davidemelozzi/Design-of-Ship-Structures/Sheetwork_DEN_DavideMelozzi.xlsx

Sheet: Ship Characteristics
Main Charateristics |  |  |  | Restriction of parameters
Lbp | 231 | [m] |  | Parameter | Min | Max | Unit | Description
B | 34.6 | [m] |  | B1 | 0.000 | 3.244 | [m] | Lenght of Bottom Tank
D | 18.1 | [m] |  | B2 | 4.325 | 6.055 | [m] | Lenght of bilge tank
T | 13.2 | [m] |  | S | 600 | 918 | [mm] | Space Framing
v | 18.2 | [kn] |  | h2 | 1.2 | 1.8 | [m] | Longitudinal Hatch
Cb | 0.78 | [-] |  | B3 | 17.3 | - | [m] | Cargo Hatch
 |  |  |  | l | 2754.000 | 4590 | [mm] | Stiffner Span
DNV Rules |  |  |  | Data for calculations
 | Rule | Real |  | LCB | 0.027 | [m]
Lbp | < 350 | 231.000 | [m] | ΔL | 11.55 | [m]
L/B | > 5 | 6.676 | [-] | R_b | 2.82 | [m]
B/D | < 2.5 | 1.912 | [-] | g | 9.810 | [m^2/s]
Cb | > 0.6 | 0.780 | [-] | ρ_sw | 1.025 | [t/m^3]
 |  |  |  | ρ_cargo | 0.800 | [t/m^3]

Sheet: Midship Section
Geometrical Basic Dimensions
B1 | 12000 | [mm]
B2 | 5300 | [mm]
B3 | 8650 | [mm]
B4 | 8651 | [mm]
C1 | 4480 | [mm]
C2 | 5006 | [mm]
C3 | 5794 | [mm]
h | 2000 | [mm]
h1 | 800 | [mm]
h2 | 1500 | [mm]
R_b | 2820 | [mm]
l | 3672 | [mm]
Plate Restrictions
 | Min Lenght [mm] | Max Lenght [mm]
Keel | 1955 | -
Bottom | 1955 | -
Inner Bottom | 1955 | -
Bilge | 1955 | -
Side | 1955 | 1800
Deck | 1955 | 1800

Sheet: Material Proprieties
Material Selection- Hull structural steel |  |  |  | Thickness Requirements | S2-B204 | Corrosion addition tk on number of components
 | Yield Stress [N/mm2] | Grade | f1 |  |  | Plates |  | Stiffeners
NV-NS | 235 | A,B,D, E | 1 |  |  | Number | tk [mm] | Number | tk [mm]
NV-27 | 265 | - | 1.08 |  |  | 1 | 1 | 1 | 1.5
NV-32 | 315 | - | 1.28 |  |  | 2 | 1 | 2 | 1.5
NV-36 | 355 | - | 1.39 |  |  | 3 | 1 | 3 | 1.5
NV-40 | 390 | - | 1.47 |  |  | 4 | 1 | 4 | 1.5
Ref | S2-B201 | S2-B202 | S2-B203 |  |  | 5 | 1 | 5 | 1.5
 |  |  |  |  |  | 6 | 1 | 6 | 1.5
Young Modulos for Steel |  |  |  |  |  | 7 | 1 | 7 | 1.5
E | 206000 | N/mm^2 |  |  |  | 8 | 1 | 8 | 1.5
 |  |  |  |  |  | 9 | 1 | 9 | 1.5
 |  |  |  |  |  | 10 | 1 | 10 | 1.5
SOLAS Requirements |  | S2-B302 |  |  |  | 11 | 0.5 | 11 | 1.5
 |  |  |  |  |  | 12 | 0.5 | 12 | 1.5
 |  |  |  |  |  | 13 | 0.5 | 13 | 1.5
 |  |  |  |  |  | 14 | 1 | 14 | 1.5
 |  |  |  |  |  | 15 | 1 | 15 | 1.5
 |  |  |  |  |  | 16 | 2 | 16 | 1.5
 |  |  |  |  |  | 17 | 2 | 17 | 1.5
 |  |  |  |  |  | 18 | 2 | 18 | 1.5
 |  |  |  |  |  | 19 | 2 | 19 | 1.5
 |  |  |  |  |  | 20 | 2 | 20 | 1.5
 |  |  |  |  |  | 21 | 2 | 21 | 1.5
 |  |  |  |  |  | 22 | 2 | 22 | 1.5
 |  |  |  |  |  | 23 | 2 | 23 | 1.5
 |  |  |  |  |  | 24 | 2 | 24 | 1.5
 |  |  |  |  |  | 25 | 1.5 | 25 | 1.5
 |  |  |  |  |  | 26 | 1.5 | 26 | 3
 |  |  |  |  |  | 27 | 1.5 | 27 | 3
 |  |  |  |  |  | 28 | 1.5 | 28 | 3
 |  |  |  |  |  | 29 | 1.5 | 29 | 3
 |  |  |  |  |  | 30 | 1.5 | 30 | 3
 |  |  |  |  |  | 31 | 1.5 | 31 | 3
 |  |  |  |  |  | 32 | 1.5 | 32 | 3
 |  |  |  |  |  | 33 | 1.5 | 33 | 3
 |  |  |  |  |  | 34 | 1.5 | 34 | 3
 |  |  |  |  |  | 35 | 1.5 | 35 | 3
 |  |  |  |  |  | 36 | 1.5 | 36 | 3
 |  |  |  |  |  | 37 | 1.5 | 37 | 3
 |  |  |  |  |  | 38 | 1.5 | 38 | 3
 |  |  |  |  |  | 39 | 1.5 | 39 | 1.5
 |  |  |  |  |  |  |  | 40 | 1.5
 |  |  |  |  |  |  |  | 41 | 1.5
 |  |  |  |  |  |  |  | 42 | 1.5
 |  |  |  |  |  |  |  | 43 | 1.5
 |  |  |  |  |  |  |  | 44 | 1.5
 |  |  |  |  |  |  |  | 45 | 1.5
 |  |  |  |  |  |  |  | 46 | 1.5
 |  |  |  |  |  |  |  | 47 | 1.5
 |  |  |  |  |  |  |  | 48 | 1
 |  |  |  |  |  |  |  | 49 | 1
 |  |  |  |  |  |  |  | 50 | 1.5
 |  |  |  |  |  |  |  | 51 | 1.5
 |  |  |  |  |  |  |  | 52 | 1.5
 |  |  |  |  |  |  |  | 53 | 1.5
 |  |  |  |  |  |  |  | 54 | 1.5
 |  |  |  |  |  |  |  | 55 | 1.5
 |  |  |  |  |  |  |  | 56 | 1.5
 |  |  |  |  |  |  |  | 57 | 1.5
 |  |  |  |  |  |  |  | 58 | 1.5
 |  |  |  |  |  |  |  | 59 | 1.5
 |  |  |  |  |  |  |  | 60 | 1.5
 |  |  |  |  |  |  |  | 61 | 1.5
 |  |  |  |  |  |  |  | 62 | 1.5
 |  |  |  |  |  |  |  | 63 | 1.5
 |  |  |  |  |  |  |  | 64 | 1.5
 |  |  |  |  |  |  |  | 65 | 1.5
 |  |  |  |  |  |  |  | 66 | 1.5
 |  |  |  |  |  |  |  | 67 | 1.5
 |  |  |  |  |  |  |  | 68 | 1.5
 |  |  |  |  |  |  |  | 69 | 1.5
 |  |  |  |  |  |  |  | 70 | 1.5
 |  |  |  |  |  |  |  | 71 | 1.5
 |  |  |  |  |  |  |  | 72 | 1.5
 |  |  |  |  |  |  |  | 73 | 1.5
 |  |  |  |  |  |  |  | 74 | 1.5
 |  |  |  |  |  |  |  | 75 | 1.5
 |  |  |  |  |  |  |  | 76 | 1.5
 |  |  |  |  |  |  |  | 77 | 1.5
 |  |  |  |  |  |  |  | 78 | 1.5
 |  |  |  |  |  |  |  | 79 | 1.5

Sheet: Design Load and Acceleration
Parameters for calculation |  |  |  | Roll motion and acceleration
Cw | 10.18 | [-] | S4-B201 | T_roll | 8.490 | [s] | S4 - B 402
Cv | 0.2 | [-] | S4-B203 | φ | 0.473 | [rad]
Cv1 | 1.20 | [-] | S4-B203 | a_roll | 1.711 | [m/s^2] | S4 - B 403
a0 | 0.37 | [-] | S4-B203 | R_roll | 6.6 | [m]
 |  |  |  | GM | 4.152 | [m] | S4 - B 402
 |  |  |  | kr | 8.65 | [m]
Surge,Sway/Yaw and Heave accelerations |  |  |  | k | 1 | [-] | S4 - B 401
Surge Acceleration |  |  |  | c | 1.038 | [-]
a_x | 0.644 | [m/s^2] | S4-B301
Combined Sway/Yaw Acceleration |  |  |  | Pitch motion and acceleration
a_y | 1.094 | [m/s^2] | S4-B302 | T_pitch | 8.735 | [s] | S4 - B 502
 |  |  |  | θ | 0.119 | [rad] | S4 - B 501
Heave Acceleration |  |  |  | a_pitch | 0.407 | [m/s^2] | S4 - B 503
a_z | 2.890 | [m/s^2] | S4-B303 | R_pitch | 6.6 | [m]
Combined Acceleration
Combined Vertical Acceleration
a(vert) | 3.272 | [m/s^2] | S4 - B 601
k(vert) | 0.7 | [-]
Combined Transverse Acceleration
a(trans) | 6.280 | [m/s^2] | S4 - B 701
Combined Longitudinal Acceleration
a(long) | 1.699 | [m/s^2] | S4 - B 801

Sheet: Longitudinal design strenght
Still water condition |  |  |  |  |  |  |  | Wave load condition |  |  |  |  |  |  |  |  | Horizontal bending moment on a wave load
S5-B106 to B108 |  |  |  |  |  |  |  | S5-B201 to B203 |  |  |  |  |  |  |  |  | S5-B205
Section | x [m] | ksm | MS (sagging) [kN.m] | MS (hogging) [kN.m] | ksq | QS (sagging) [kN] | QS (hogging) [kN] | Section | x [m] | ksm | MS (sagging) [kN.m] | MS (hogging) [kN.m] | ksq,neg | ksq,pos | QS (sagging) [kN] | QS (hogging) [kN] | Section | x [m] | x/L | M_wh [kN*m]
0 | 0 | 0 | 0 | 0 | 0.00 | 0 | 0 | 0 | 0 | 0.000 | 0 | 0 | 0.000 | 0.000 | 0 | 0 | 0 | 0 | 0 | 0
1 | 11.55 | 0.075 | -135565.5894 | 156139.9928 | 0.33 | -13041.42274 | 15020.68233 | 1 | 11.55 | 0.125 | -382364.483 | 348073.8107 | 0.230 | 0.209 | -8306.383101 | 7565.787546 | 1 | 11.55 | 0.05 | 41198.64356
2 | 23.1 | 0.15 | -271131.1788 | 312279.9856 | 0.67 | -26082.84549 | 30041.36466 | 2 | 23.1 | 0.250 | -764728.9659 | 696147.6213 | 0.460 | 0.419 | -16612.7662 | 15131.57509 | 2 | 23.1 | 0.1 | 160761.764
3 | 34.65 | 0.3625 | -655233.6822 | 754676.6319 | 1.00 | -39124.26823 | 45062.04698 | 3 | 34.65 | 0.375 | -1147093.449 | 1044221.432 | 0.690 | 0.628 | -24919.1493 | 22697.36264 | 3 | 34.65 | 0.15 | 346985.6899
4 | 46.2 | 0.575 | -1039336.186 | 1197073.278 | 1.00 | -39124.26823 | 45062.04698 | 4 | 46.2 | 0.500 | -1529457.932 | 1392295.243 | 0.920 | 0.838 | -33225.5324 | 30263.15018 | 4 | 46.2 | 0.2 | 581641.5261
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
 |  |  | Cw | Ms Sag [kN*m] | Ms Hog [kN*m] | Q Sag [kN*m] | Q Hog [kN*m] |  |  |  | Cw | Ms Sag [kN*m] | Ms Hog [kN*m] | Q Neg [kN*m] | Q Pos [kN*m]
 |  |  | 10.18 | -1807541.192 | 2081866.571 | -39124.26823 | 45062.04698 |  |  |  | 10.18 | -3058915.864 | 2784590.485 | -36114.70914 | 36114.70914

Sheet: Bottom structures
 |  |  |  | Plates
 |  |  |  | Keel Plate
 |  |  |  | Plate | Breadth [m] | Breadth [m] | Material | Thickness [mm] | ICM [mm] | Gross Thickness [mm]
 |  |  |  | nº | b_min | b | f1 | t_min | tk | t
 |  |  |  | 1 | 1.955 | 2 | 1.39 | 17.80 | 1 | 18
 |  |  |  |  | S6 - C 201 |  |  | S6 - C 202
 |  |  |  | Bottom and bilge plates
 |  |  |  | Plate | Breadth [m] | Thickness [mm] | Breadth [m] | Thickness [mm] |  | s | p1 | p2 | p3 | p | σ | pdp | pl | y | z | kf | hs | Material
 |  |  |  | nº | b | t | b_min | t_min | t_req | [m] | [kN/m^2] | [kN/m^2] | [kN/m^2] | [kN/m^2] | [-] | [kN/m^2] | [-] | [m] | [m] | [m] | [m] | f1
 |  |  |  | 2 | 2.25 | 15 | 1.955 | 14.3 | 13.8 | 0.75 | 152.1 | -22.7 | -11.1 | 152.1 | 139.0 | 20.1 | 25.3 | 8.65 | 0 | 4.9 | 2 | 1.39
 |  |  |  | 3 | 2.25 | 15 | 1.955 | 14.3 | 13.8 | 0.75 | 152.1 | -22.7 | -11.1 | 152.1 | 139.0 | 20.1 | 25.3 | 8.65 | 0 | 4.9 | 2 | 1.39
 |  |  |  | 4 | 2.25 | 15 | 1.955 | 14.3 | 13.8 | 0.75 | 152.1 | -22.7 | -11.1 | 152.1 | 139.0 | 20.1 | 25.3 | 8.65 | 0 | 4.9 | 2 | 1.39
 |  |  |  | 5 | 2.25 | 15 | 1.955 | 14.4 | 13.8 | 0.75 | 152.3 | -22.7 | -11.1 | 152.3 | 139.0 | 20.3 | 25.3 | 8.875 | 0 | 4.9 | 2 | 1.39
 |  |  |  | 6 | 2.25 | 15 | 1.955 | 14.5 | 13.8 | 0.75 | 155.1 | -22.7 | -11.1 | 155.1 | 139.0 | 23.1 | 25.3 | 11.125 | 0 | 4.9 | 2 | 1.39
 |  |  |  | 7 | 2.00 | 17 | 1.955 | 16.0 | 13.8 | 0.83 | 157.7 | -22.7 | -11.1 | 157.7 | 139.0 | 25.7 | 25.3 | 13.25 | 0 | 4.9 | 2 | 1.39
 |  |  |  | 8 | 4.89 | 17 | 1.955 | 16.3 | 13.8 | 0.83 | 162.7 | 0.7 | 9.0 | 162.7 | 139.0 | 30.7 | 25.3 | 16.475 | 0.826 | 4.9 | 4 | 1.39
 |  |  |  | 9 | 2.33 | 17 | 1.955 | 16.7 | 13.6 | 0.88 | 167.8 | -8.7 | 1.0 | 167.8 | 153.0 | 35.8 | 25.3 | 17.3 | 4.2125 | 4.9 | 3.2 | 1.47
 |  |  |  | 10 | 2.33 | 17 | 1.955 | 16.8 | 13.6 | 0.88 | 170.6 | -34.5 | -21.1 | 170.6 | 153.0 | 38.6 | 25.3 | 17.3 | 6.5375 | 4.9 | 1 | 1.47
 |  |  |  |  |  |  | S6 - C 301 | S6 - C 304 | S6 - C 302 |  | S6 - Table B1 |  |  |  | S6 - C 302 | S4 - C 201 | S4 - C 302
 |  |  |  | Inner bottom plating
 |  |  |  | Plate | Breadth [m] | Thickness [mm] | Breadth [m] | Thickness [mm] |  | s | p4 | p13 | p14 | p15 | p | σ | pdp | pl | y | z | kf | hc | hp | Δpdyn | hs | Material
Constant values |  |  |  | nº | b | t | b_min | t_min | t_req | [m] | [kN/m^2] | [kN/m^2] | [kN/m^2] | [kN/m^2] | [kN/m^2] | [-] | [kN/m^2] | [-] | [m] | [m] | [m] | [-] | [m] | [kN/m^2] | [m] | f1
p0 | 15 | kN/m~2 | S4 - C 302 | 28 | 3.73 | 15 | 1.955 | 14.11 | 13.22 | 0.83 | 158.38 | 108.54 | 88.00 | 132.00 | 158.38 | 198.47 | 36.32 | 25.25 | 16 | 6 | 4.9 | 13.5 | 13.7 | 25 | 7.3 | 1.47
t0 | 6 | mm | S6 C402 | 29 | 3.73 | 15 | 1.955 | 14.59 | 13.22 | 0.83 | 170.70 | 123.95 | 124.00 | 132.00 | 170.70 | 198.47 | 29.88 | 25.25 | 13.4 | 3.3 | 4.9 | 14.55 | 16 | 25 | 10.9 | 1.47
ka | 1.08 | [-] | S6 - A 201 | 30 | 3.025 | 14 | 1.955 | 13.94 | 13.22 | 0.75 | 188.89 | 134.67 | 158.90 | 132.00 | 188.89 | 198.47 | 24.75 | 25.25 | 10.5 | 2 | 4.9 | 16.1 | 17.6 | 25 | 14.39 | 1.47
f2b | 0.868 | [-] |  | 31 | 3.025 | 14 | 1.955 | 13.94 | 13.22 | 0.75 | 188.89 | 134.67 | 176.00 | 132.00 | 188.89 | 198.47 | 22.47 | 25.25 | 8.65 | 2 | 4.9 | 16.1 | 17.6 | 25 | 16.1 | 1.47
Zb | 31941165.65 | [cm^3] |  | 32 | 2.525 | 14 | 1.955 | 13.94 | 13.22 | 0.75 | 188.89 | 134.67 | 176.00 | 132.00 | 188.89 | 198.47 | 22.47 | 25.25 | 8.65 | 2 | 4.9 | 16.1 | 17.6 | 25 | 16.1 | 1.47
I | 1.927116994e+10 | [cm^4] | S5-C401 | 33 | 2.525 | 14 | 1.955 | 13.94 | 13.22 | 0.75 | 188.89 | 134.67 | 176.00 | 132.00 | 188.89 | 198.47 | 22.47 | 25.25 | 8.65 | 2 | 4.9 | 16.1 | 17.6 | 25 | 16.1 | 1.47
Tm | 4.62 | [m] | S6 - C 402 | 34 | 2 | 14 | 1.955 | 13.94 | 13.22 | 0.75 | 188.89 | 134.67 | 176.00 | 132.00 | 188.89 | 198.47 | 22.47 | 25.25 | 8.65 | 2 | 4.9 | 16.1 | 17.6 | 25 | 16.1 | 1.47
ks | 2 | [-] | S4-C201 |  |  |  |  | S6 - C 402 | S6 - C 401 |  | S6 - Table B1 |  |  |  |  | S6 - C 302 | S4 - C 201 |  |  |  |  |  |  | S4 - C 302
f | 4.9 | [m] | S4 - C 201
Z_NA | 6.03 | [m] | p | Longitudinal Girder
 |  |  |  | Plate | Breadth [m] | Thickness [mm] | Thickness [mm] |  | k | s | p13 | p14 | p15 | p | σ | hp | Δpdyn | hs | Material
 |  |  |  | nº | b | t | t_min | t_req | [-] | [m] | [kN/m^2] | [kN/m^2] | [kN/m^2] | [kN/m^2] | [-] | [m] | [kN/m^2] | [m] | f1
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
 |  |  |  | 73 | 972.2280707 | 10 | 66.73510531 | 9.5 | 66.73510531 | 3.672 | 3.465 | 0.8 | 1.09 | 174.2 | 144.05 | 144.05 | 29 | 132 | 1.4 | 19 | 25 | 1.28
 |  |  |  | 74 | 936.0521425 | 10 | 66.73510531 | 9.5 | 65.06922095 | 3.672 | 3.465 | 0.8 | 1.09 | 174.2 | 138.69 | 138.69 | 21 | 132 | 0.6 | 18.2 | 25 | 1.28
 |  |  |  | 75 | 972.2280707 | 10 | 66.73510531 | 9.5 | 66.73510531 | 3.672 | 3.465 | 0.8 | 1.09 | 174.2 | 144.05 | 144.05 | 29 | 132 | 1.4 | 19 | 25 | 1.28
 |  |  |  | 76 | 936.0521425 | 10 | 66.73510531 | 9.5 | 65.06922095 | 3.672 | 3.465 | 0.8 | 1.09 | 174.2 | 138.69 | 138.69 | 21 | 132 | 0.6 | 18.2 | 25 | 1.28
 |  |  |  | 77 | 972.2280707 | 10 | 66.73510531 | 9.5 | 66.73510531 | 3.672 | 3.465 | 0.8 | 1.09 | 174.2 | 144.05 | 144.05 | 29 | 132 | 1.4 | 19 | 25 | 1.28
 |  |  |  | 78 | 936.0521425 | 10 | 66.73510531 | 9.5 | 65.06922095 | 3.672 | 3.465 | 0.8 | 1.09 | 174.2 | 138.69 | 138.69 | 21 | 132 | 0.6 | 18.2 | 25 | 1.28
 |  |  |  | 79 | 972.2280707 | 10 | 66.73510531 | 9.5 | 66.73510531 | 3.672 | 3.465 | 0.8 | 1.09 | 174.2 | 144.05 | 144.05 | 29 | 132 | 1.4 | 19 | 25 | 1.28

Sheet: Side structures
 |  |  |  | Plates
 |  |  |  | Side Plates
 |  |  |  | Plate | Breadth [m] | Thickness [mm] | t_min | t_req | k | σ | s | p | p1 | p2 | p6 | p8 | pdp | pl | y | z | kf | h0 | hs | bb | Material
 |  |  |  | nº | b | t | [mm] | [mm] | [-] | [-] | [m] | [kN/m^2] | [kN/m^2] | [kN/m^2] | [kN/m^2] | [kN/m^2] | [KN/m^2] | [-] | [m] | [m] | [m] | [m] | [m] | [m] | f1
 |  |  |  | 11 | 1.8 | 14 | 7.54 | 13.30 | 0.01 | 153.6 | 0.918 | 103.2439296 | 77.64372393 | - | 103.2439296 | 73.46272 | 31.64372393 | 15.85441736 | 17.3 | 8.6 | 4.9 | 4.6 | 9.5 | 34.6 | 1.28
 |  |  |  | 12 | 1.8 | 13 | 7.54 | 12.70 | 0.01 | 153.6 | 0.918 | 93.77924161 | 61.80372393 | - | 93.77924161 | 73.46272 | 33.80372393 | 15.85441736 | 17.3 | 10.4 | 4.9 | 2.8 | 7.7 | 34.6 | 1.28
 |  |  |  | 13 | 1.8 | 13 | 7.54 | 12.07 | 0.01 | 153.6 | 0.918 | 84.31455361 | 45.96372393 | - | 84.31455361 | 73.46272 | 35.96372393 | 15.85441736 | 17.3 | 12.2 | 4.9 | 1 | 5.9 | 34.6 | 1.28
 |  |  |  | 14 | 1.8 | 11 | 8.04 | 10.02 | 0.01 | 179.2 | 0.725 | 95.90139031 | - | 34.28372393 | 95.90139031 | - | 37.16372393 | 15.85441736 | 17.3 | 13.2 | 4.9 | 0.8 | 4.1 | 34.6 | 1.28
 |  |  |  | 15 | 1.8 | 10 | 8.04 | 9.43 | 0.01 | 179.2 | 0.725 | 83.77475881 | - | 27.80372393 | 83.77475881 | - | 37.16372393 | 15.85441736 | 17.3 | 13.2 | 4.9 | 2.6 | 2.3 | 34.6 | 1.28
 |  |  |  |  |  |  | S7-C102 | S7-C101 | S7-C102 |  |  | S7-B100
 |  |  |  | Shear Strake
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
p0 | 15 | kN/m^2 | S4 - C 302
 | 25
ka | 1.08 | [-]
b | 25.95 | m | S7 - B 101
f2d | 1.74 | [-]
T ballast | 4.62 | [m] | S6 - C 402

Sheet: Deck structures
 |  |  |  | Plates
 |  |  |  | Strength deck plates
 |  |  |  | Plate | Breadth [m] | Thickness [mm] | t_min | t_req | t0 | k | s | σ | p | p1 | p7 | p8 | pdp | pl | y | z | kf | hp | Δpdyn | hs | h0 | Material
 |  |  |  | nº | b | t | [mm] | [mm] | [-] | [-] | [m] | [-] | [KN/m^2] | [KN/m^2] | [KN/m^2] | [KN/m^2] | [KN/m^2] | [-] | [m] | [m] | [m] | [m] | [kN/m^2] | [m] | [m] | f1
 |  |  |  | 17 | 1.8 | 12 | 11.42 | 8.82 | 5.5 | 0.02 | 0.865 | 166.8 | 26.9 | 19.1 | 26.9 | 15.0 | 45.45441583 | 25.25368591 | 16.4 | 13.2 | 4.9 | 1.5 | 25 | 0 | 4.9 | 1.39
 |  |  |  | 18 | 1.8 | 12 | 11.42 | 8.82 | 5.5 | 0.02 | 0.865 | 166.8 | 26.9 | 17.3 | 26.9 | 15.0 | 43.23726255 | 25.25368591 | 14.6 | 13.2 | 4.9 | 1.5 | 25 | 0 | 4.9 | 1.39
 |  |  |  | 19 | 1.8 | 12 | 11.42 | 8.82 | 5.5 | 0.02 | 0.865 | 166.8 | 26.9 | 15.6 | 26.9 | 15.0 | 41.02010926 | 25.25368591 | 12.8 | 13.2 | 4.9 | 1.5 | 25 | 0 | 4.9 | 1.39
 |  |  |  | 20 | 1.8 | 12 | 11.42 | 8.82 | 5.5 | 0.02 | 0.865 | 166.8 | 26.9 | 13.8 | 26.9 | 15.0 | 38.80295598 | 25.25368591 | 11 | 13.2 | 4.9 | 1.5 | 25 | 0 | 4.9 | 1.39
 |  |  |  | 21 | 1.8 | 12 | 11.42 | 8.82 | 5.5 | 0.02 | 0.865 | 166.8 | 26.9 | 12.0 | 26.9 | 15.0 | 36.5858027 | 25.25368591 | 9.2 | 13.2 | 4.9 | 1.5 | 25 | 0 | 4.9 | 1.39
 |  |  |  |  |  |  | S8 - C 104 | S8 - C 102 | S8 - C 104 |  |  | S8 - C 102 |  | S8 - table 1 |  |  |  | S4 - C 201 |  |  |  |  |  |  |  | S8 - B 101
 |  |  |  | Plates of deck below and above strength deck
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
 |  |  |  |  | 49 | 60.85093043 | 9 | 14 | 8.31 | 10.52011276 | 3 | 0.75 | 1.09 | 62.2 | 6.198671353 | 35.9 | 25.3 | 8.65 | 13.2 | 4.9 | 6.4 | 1.28

Sheet: Longitudinal components
Requirements |  |  |  |  |  |  | Requirements Maximum
Structure | Stiffener | SecMudul. [cm^3] | Thickness [mm] | Area [cm^2] | Material | Plate | Structure | SecMudul. [cm^3] | Thickness [mm] | Area [cm^2] | Longitudinal
 | nº | Z | t | A | f1 | nº |  | Z | t | A
Outer Bottom | 1 | 1067.7 | 10 | 85.23061778 | 1.28 | 1 | Outer Bottom | 1404 | 10 | 86 | HP400 X 16
 | 2 | 1067.7 | 10 | 85.23061778 | 1.28 | 2 | Inner Bottom | 1036 | 10 | 70 | HP370 X 15
 | 3 | 1067.7 | 10 | 85.23061778 | 1.28 |  | Double Bottom | 973 | 10 | 67 | HP340 x 12
 | 4 | 1067.7 | 10 | 85.23061778 | 1.28 | 3 | Side | 276 | 10 | 29 | HP220 X 10
 | 5 | 1067.7 | 10 | 85.23061778 | 1.28 |  | Shear Strake | 214 | 10 | 29 | HP220 X 10
 | 6 | 1067.7 | 10 | 85.23061778 | 1.28 |  | Strength Deck | 438 | 10 | 40 | HP260 x 12
 | 7 | 1067.7 | 10 | 85.23061778 | 1.28 | 4 | Below Deck | 1207 | 10 | 78 | HP370 X 13
 | 8 | 1067.7 | 10 | 85.23061778 | 1.28 |  | Above Deck | 87 | 9 | 14 | HP140 X 10
 | 9 | 1067.7 | 10 | 85.23061778 | 1.28 | 5 | Trans. Stiff. | 425.6138523 | - | 38.47566035 | HP260 x 12
 | 10 | 1077.2 | 10 | 85.23061778 | 1.28
 | 11 | 1083.7 | 10 | 85.23061778 | 1.28 | 6
 | 12 | 1090.2 | 10 | 85.23061778 | 1.28
 | 13 | 1221.5 | 10 | 85.23061778 | 1.28 | 7
 | 14 | 1229.5 | 10 | 85.23061778 | 1.28
 | 15 | 1237.4 | 10 | 85.23061778 | 1.28 | 8
 | 16 | 1368.4 | 10 | 85.23061778 | 1.28
 | 17 | 1377.1 | 10 | 85.23061778 | 1.28 | 9
 | 18 | 1385.8 | 10 | 85.23061778 | 1.28
 | 19 | 1394.5 | 10 | 85.23061778 | 1.28 | 10
 | 20 | 1403.2 | 10 | 85.23061778 | 1.28
Inner Bottom | 50 | 1025.7 | 10 | 69.58237648 | 1.28 | 28
 | 51 | 1025.7 | 10 | 69.58237648 | 1.28
 | 52 | 1025.7 | 10 | 69.58237648 | 1.28
 | 53 | 1025.7 | 10 | 69.58237648 | 1.28
 | 54 | 1025.7 | 10 | 69.58237648 | 1.28 | 29
 | 55 | 1025.7 | 10 | 69.58237648 | 1.28
 | 56 | 1025.7 | 10 | 69.58237648 | 1.28
 | 57 | 1027.1 | 10 | 69.58237648 | 1.28
 | 58 | 1035.1 | 10 | 69.58237648 | 1.28 | 30
 | 59 | 1035.1 | 10 | 69.58237648 | 1.28
 | 60 | 1035.1 | 10 | 69.58237648 | 1.28
 | 61 | 1035.1 | 10 | 69.58237648 | 1.28 | 31
 | 62 | 1035.1 | 10 | 69.58237648 | 1.28
 | 63 | 1035.1 | 10 | 69.58237648 | 1.28
 | 64 | 1035.1 | 10 | 69.58237648 | 1.28 | 32
 | 65 | 1035.1 | 10 | 69.58237648 | 1.28
 | 66 | 1035.1 | 10 | 69.58237648 | 1.28
 | 67 | 1035.1 | 10 | 69.58237648 | 1.28 | 33
 | 68 | 1035.1 | 10 | 69.58237648 | 1.28
 | 69 | 1035.1 | 10 | 69.58237648 | 1.28 | 34
Double Bottom | 70 | 936.1 | 10 | 66.73510531 | 1.28 | 35
 | 71 | 972.2 | 10 | 66.73510531 | 1.28
 | 72 | 936.1 | 10 | 66.73510531 | 1.28 | 36
 | 73 | 972.2 | 10 | 66.73510531 | 1.28
 | 74 | 936.1 | 10 | 66.73510531 | 1.28 | 37
 | 75 | 972.2 | 10 | 66.73510531 | 1.28
 | 76 | 936.1 | 10 | 66.73510531 | 1.28 | 38
 | 77 | 972.2 | 10 | 66.73510531 | 1.28
 | 78 | 936.1 | 10 | 66.73510531 | 1.28 | 39
 | 79 | 972.2 | 10 | 66.73510531 | 1.28
Side | 21 | 275.9 | 10 | 29 | 1.28 | 13
 | 22 | 262.8 | 10 | 29 | 1.28 | 14
 | 23 | 249.6 | 10 | 29 | 1.28
 | 24 | 236.4 | 10 | 29 | 1.28 | 15
 | 25 | 223.3 | 10 | 29 | 1.28
 | 26 | 227.5 | 10 | 29 | 1.28
Shear Strake | 27 | 213.2 | 10 | 29 | 1.28 | 16
Strenght Deck | 28 | 437.8 | 10 | 40 | 1.28 | 17
 | 29 | 437.8 | 10 | 40 | 1.28
 | 30 | 437.8 | 10 | 40 | 1.28 | 18
 | 31 | 437.8 | 10 | 40 | 1.28
 | 32 | 437.8 | 10 | 40 | 1.28 | 19
 | 33 | 437.8 | 10 | 40 | 1.28
 | 34 | 437.8 | 10 | 40 | 1.28 | 20
 | 35 | 437.8 | 10 | 40 | 1.28
 | 36 | 437.8 | 10 | 40 | 1.28 | 21
Below Deck | 37 | 47.6 | 10 | 78 | 1.28 | 23
 | 38 | 670.3 | 10 | 78 | 1.28 | 24
 | 39 | 672.9 | 9 | 78 | 1.28
 | 40 | 726.7 | 9 | 78 | 1.28 | 25
 | 41 | 780.4 | 9 | 78 | 1.28
 | 42 | 834.2 | 9 | 78 | 1.28
 | 43 | 887.9 | 9 | 78 | 1.28 | 26
 | 44 | 965.7 | 9 | 78 | 1.28
 | 45 | 1045.9 | 9 | 78 | 1.28
 | 46 | 1126.1 | 9 | 78 | 1.28 | 27
 | 47 | 1206.3 | 9 | 78 | 1.28
Above Deck | 48 | 86.8 | 9 | 14 | 1.28 | 22
 | 49 | 60.9 | 9 | 14 | 1.28

Sheet: Neutral Axis Correction
Plates
Structure | Plate | h | b | I0 | A | z | A.z | A.z^2 | I |  | Designation | A | h | tw | Plate area | Dist. of CG [mm] |  | 2nd mom. of area [cm^4] |  | Elastic modulus [cm^3]
 | nº | [m] | [mm] | [m^4] | [m^2] | [m] | [m^3] | [m^4] | [m^4] |  |  | [cm^2] | [mm] | [mm] | [cm^2] | x | y | Ix | Iy | xx | yy
Outer Bottom | 1 | 0.009 | 1 | 6.075e-08 | 0.009 | 0.018 | 0.000162 | 0.3264636887 | 0.3264637495 |  | HP140x10 | 16.630 | 140 | 10 | 60 | 79.2 | 7.00 | 316 | 5.56 | 39.80 | 7.94
 | 2 | 0.015 | 2.25 | 6.328125e-07 | 0.03375 | 0.015 | 0.00050625 | 1.225458747 | 1.22545938 |  | HP160x9 | 17.800 | 160 | 9 | 60 | 93.6 | 7.10 | 448 | 7.32 | 47.90 | 10.30
 | 3 | 0.015 | 2.25 | 6.328125e-07 | 0.03375 | 0.015 | 0.00050625 | 1.225458747 | 1.22545938 |  | HP180x10 | 22.46 | 180 | 10 | 60 | 106 | 8.10 | 717 | 12.05 | 67.80 | 14.90
 | 4 | 0.015 | 2.25 | 6.328125e-07 | 0.03375 | 0.015 | 0.00050625 | 1.225458747 | 1.22545938 |  | HP200x9 | 23.66 | 200 | 9 | 100 | 121 | 8.40 | 941 | 15.76 | 77.70 | 18.80
 | 5 | 0.015 | 2.25 | 6.328125e-07 | 0.03375 | 0.015 | 0.00050625 | 1.225458747 | 1.22545938 |  | HP200x10 | 25.660 | 200 | 10 | 100 | 119 | 8.70 | 1020 | 17.21 | 85.00 | 19.80
 | 6 | 0.015 | 2.25 | 6.328125e-07 | 0.03375 | 0.015 | 0.00050625 | 1.225458747 | 1.22545938 |  | HP200x12 | 29.660 | 200 | 12 | 100 | 117 | 9.40 | 1160 | 20.46 | 99.60 | 21.80
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
 | 47 | 370 | 13 | 1.767e-06 | 0.00697 | 12.75 | 0.0888675 | 0.313746076 | 0.313747843
Above Deck | 48 | 140 | 10 | 3.16e-06 | 0.001663 | 18.85 | 0.03134755 | 0.2728590627 | 0.2728622227 | HP140 X 10
 | 49 | 140 | 10 | 3.16e-06 | 0.001663 | 19.6 | 0.0325948 | 0.3057471276 | 0.3057502876

Sheet: Buckling
 |  | Thicknesses |  |  |  |  |  |  |  | Ideal elastic buckling stress |  | Yield stress of material | Critical buckling stress | Compressive stress in plate
 | Plate | t_initial | t_final | t_addiction | tk | η | k | ψ | s | σel | f1 | σf | σc | σa | Z _bottom | zn | za | ZND
 | nº | [mm] | [mm] | [mm] | [mm] | [-] | [-] | [-] | [m] | [N/mm^2] | [-] | [N/mm^2] | [N/mm^2] | [N/mm^2] | [m] | [m] | [m] | [m]
Outer Bottom | 1 | 18 | 15 | 0 | 1 | 0.9 | 4.00 | 1 | 0.75 | 258.4064 | 1.39 | 355 | 233.1 | 162.3 | 0.018 | 7.56 | 0.016 | 10.54 | OK
 | 2 | 15 | 15 | 0 | 1 | 0.9 | 4.00 | 1 | 0.75 | 258.4064 | 1.39 | 355 | 233.1 | 162.3 | 0.015 | 7.56 | 0.015 | 10.54 | OK
 | 3 | 15 | 15 | 0 | 1 | 0.9 | 4.00 | 1 | 0.75 | 258.4064 | 1.39 | 355 | 233.1 | 162.3 | 0.015 | 7.56 | 0.015 | 10.54 | OK
 | 4 | 15 | 15 | 0 | 1 | 0.9 | 4.00 | 1 | 0.75 | 258.4064 | 1.39 | 355 | 233.1 | 162.3 | 0.015 | 7.56 | 0.015 | 10.54 | OK
 | 5 | 15 | 15 | 0 | 1 | 0.9 | 4.00 | 1 | 0.75 | 258.4064 | 1.39 | 355 | 233.1 | 162.3 | 0.015 | 7.56 | 0.015 | 10.54 | OK
 | 6 | 15 | 15 | 0 | 1 | 0.9 | 4.00 | 1 | 0.75 | 258.4064 | 1.39 | 355 | 233.1 | 162.3 | 0.015 | 7.56 | 0.015 | 10.54 | OK
 | 7 | 17 | 16 | 0 | 1 | 0.9 | 4.00 | 1 | 0.83 | 242.2122224 | 1.39 | 355 | 224.9 | 162.2 | 0.017 | 7.56 | 0.017 | 10.54 | OK
 | 8 | 17 | 15 | 0 | 1 | 0.9 | 4.00 | 1 | 0.83 | 210.9937582 | 1.39 | 355 | 205.7 | 139.8 | 1.06 | 7.56 | 1.06 | 10.54 | OK
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
 | 3 | 15 | 15 | 15 | 1.39
 | 4 | 15 | 15 | 15 | 1.39
 | 5 | 15 | 15 | 15 | 1.39
 | 6 | 15 | 15 | 15 | 1.39
 | 7 | 17 | 16 | 17 | 1.39
 | 8 | 17 | 15 | 17 | 1.39
 | 9 | 17 | 15 | 17 | 1.47
 | 10 | 17 | 15 | 17 | 1.47
Inner Bottom | 28 | 15 | 15 | 15 | 1.47
 | 29 | 15 | 15 | 15 | 1.47
 | 30 | 14 | 14 | 14 | 1.47
 | 31 | 14 | 14 | 14 | 1.47
 | 32 | 14 | 14 | 14 | 1.47
 | 33 | 14 | 14 | 14 | 1.47
 | 34 | 14 | 14 | 14 | 1.47
Double Bottom | 35 | 16 | 14 | 16 | 1.39
 | 36 | 16 | 14 | 16 | 1.39
 | 37 | 16 | 14 | 16 | 1.39
 | 38 | 16 | 14 | 16 | 1.39
 | 39 | 16 | 14 | 16 | 1.39
Side | 11 | 14 | 16 | 16 | 1.28
 | 12 | 13 | 16 | 16 | 1.28
 | 13 | 13 | 18 | 18 | 1.28
 | 14 | 11 | 18 | 18 | 1.39
 | 15 | 10 | 25 | 25 | 1.39
Shear Strake | 16 | 11 | 25 | 25 | 1.47
Strength Deck | 17 | 12 | 25 | 25 | 1.47
 | 18 | 12 | 25 | 25 | 1.47
 | 19 | 12 | 25 | 25 | 1.47
 | 20 | 12 | 25 | 25 | 1.47
 | 21 | 12 | 25 | 25 | 1.47
Above Deck | 22 | 12 | 24 | 24 | 1.47
Below Deck | 23 | 12 | 24 | 24 | 1.47
 | 24 | 12 | 24 | 24 | 1.47
 | 25 | 12 | 24 | 24 | 1.47
 | 26 | 12 | 24 | 24 | 1.47
 | 27 | 12 | 24 | 24 | 1.47

Sheet: Neutral Axis Correction partII
Plates
Structure | Plate | h | b | I0 | A | z | A.z | A.z^2 | I | Material |  | Designation | A | h | tw | Plate area | Dist. of CG [mm] |  | 2nd mom. of area [cm^4] |  | Elastic modulus [cm^3]
 | nº | [m] | [mm] | [m^4] | [m^2] | [m] | [m^3] | [m^4] | [m^4] | f1 |  |  | [cm^2] | [mm] | [mm] | [cm^2] | x | y | Ix | Iy | xx | yy
Outer Bottom | 1 | 0.018 | 1 | 4.86e-07 | 0.018 | 0.018 | 0.000324 | 1.02 | 1.02 | 1.39 |  | HP140x10 | 16.630 | 140 | 10 | 60 | 79.2 | 7.00 | 316 | 5.56 | 39.80 | 7.94
 | 2 | 0.015 | 2.25 | 6.328125e-07 | 0.03375 | 0.015 | 0.00050625 | 1.92 | 1.92 | 1.39 |  | HP160x9 | 17.800 | 160 | 9 | 60 | 93.6 | 7.10 | 448 | 7.32 | 47.90 | 10.30
 | 3 | 0.015 | 2.25 | 6.328125e-07 | 0.03375 | 0.015 | 0.00050625 | 1.92 | 1.92 | 1.39 |  | HP180x10 | 22.46 | 180 | 10 | 60 | 106 | 8.10 | 717 | 12.05 | 67.80 | 14.90
 | 4 | 0.015 | 2.25 | 6.328125e-07 | 0.03375 | 0.015 | 0.00050625 | 1.92 | 1.92 | 1.39 |  | HP200x9 | 23.66 | 200 | 9 | 100 | 121 | 8.40 | 941 | 15.76 | 77.70 | 18.80
 | 5 | 0.015 | 2.25 | 6.328125e-07 | 0.03375 | 0.015 | 0.00050625 | 1.92 | 1.92 | 1.39 |  | HP200x10 | 25.660 | 200 | 10 | 100 | 119 | 8.70 | 1020 | 17.21 | 85.00 | 19.80
 | 6 | 0.015 | 2.25 | 6.328125e-07 | 0.03375 | 0.015 | 0.00050625 | 1.92 | 1.92 | 1.39 |  | HP200x12 | 29.660 | 200 | 12 | 100 | 117 | 9.40 | 1160 | 20.46 | 99.60 | 21.80
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
 | 40 | 370 | 13 | 1.767e-06 | 0.00697 | 15.935 | 0.11106695 | 0.4892117862 | 0.4892135532 | 1.47
 | 41 | 370 | 13 | 1.767e-06 | 0.00697 | 15.48 | 0.1078956 | 0.4375166241 | 0.4375183911 | 1.47
 | 42 | 370 | 13 | 1.767e-06 | 0.00697 | 15.025 | 0.10472425 | 0.3887073905 | 0.3887091575 | 1.47
 | 43 | 370 | 13 | 1.767e-06 | 0.00697 | 14.57 | 0.1015529 | 0.3427840854 | 0.3427858524 | 1.47
 | 44 | 370 | 13 | 1.767e-06 | 0.00697 | 14.115 | 0.09838155 | 0.2997467088 | 0.2997484758 | 1.47
 | 45 | 370 | 13 | 1.767e-06 | 0.00697 | 13.66 | 0.0952102 | 0.2595952607 | 0.2595970277 | 1.47
 | 46 | 370 | 13 | 1.767e-06 | 0.00697 | 13.205 | 0.09203885 | 0.2223297411 | 0.2223315081 | 1.47
 | 47 | 370 | 13 | 1.767e-06 | 0.00697 | 12.75 | 0.0888675 | 0.18795015 | 0.187951917 | 1.47
Above Deck | 48 | 370 | 13 | 1.767e-06 | 0.00697 | 18.85 | 0.03134755 | 0.8888718144 | 0.8888735814 | 1.47
 | 49 | 370 | 13 | 1.767e-06 | 0.00697 | 19.6 | 0.0325948 | 1.010859083 | 1.01086085 | 1.47

Sheet: Transversal Bulkhead
Main Charateristics |  |  |  | SecMudul. [cm^3] | Thickness [mm] | Area [cm^2] | t_min | A_req | l | s | wk | σ | p | Material
tank breadth | 34.6 | [m] |  | Z | t | A | [mm] | [cm^2] | [m] | [m] | [-] | [-] | [KN/m^2] | f1
s1 / sc | 1.44 | [m] |  | 921.4034033 | 9 | 65 | 8.31 | 64.3885711 | 3.4 | 0.85 | 1.18 | 204.8 | 162.75 | 1.28
s2 / a | 0.94 | [m]
s3 / c | 1.12 | [m] |  | s | wk | σ | p | Material
α | 1.11 | [rad] |  | [m] | [-] | [-] | [KN/m^2] | f1 |  |  |  |  |  |  |  |  |  |  | Structure | SecMudul. [cm^3] | Thickness [mm] | Area [cm^2] | Longitudinal
d | 1 | [m] |  | 0.85 | 1.18 | 204.8 | 162.75 | 1.28 |  |  |  |  |  |  |  |  |  |  |  | Z | t | A
Height of lower ends | 5.3 | [m] |  | Trans. Bulkhead | 1018 | 14 | 65.54 | HP 340x14 |  |  |  |  |  |  |  |  |  |  | Trans. Bulkhead | 1018 | 14 | 65.54 | HP 340x14
Height of upper end | 5.794 | [m]
Plate | Breadth | Final thickness | corrugated thickness | required thickness | minimum thickness | P | σ | s | t_k | tn | k | p1 | p2 | K | δ | hc | hb | Material
nº | [m] | [mm] | [mm] | [mm] | [mm] | [kN/m²] | [-] | [m] | [mm] | [mm] | [-] | [kN/m²] | [kN/m²] | [-] | [º] | [m] | [m] | f1
1 | 2.7 | 17 | 16.1 | 14.6 | 10.4 | 162.75 | 305.8 | 1.17 | 1.5 | 14 | 0.02 | 162.75 | 83.33727923 | 0.56 | 20 | 16.275 | 16.275 | 1.39
2 | 2.7 | 17 | 16.1 | 14.6 | 10.4 | 162.75 | 305.8 | 1.17 | 1.5 | 14 | 0.02 | 136.25 | 69.76776833 | 0.56 | 20 | 13.625 | 13.625 | 1.39
3 | 2.5 | 17 | 16.1 | 14.6 | 10.4 | 162.75 | 305.8 | 1.17 | 1.5 | 14 | 0.02 | 110.48 | 56.57205905 | 0.56 | 20 | 11.048 | 11.048 | 1.39
4 | 2.5 | 17 | 16.1 | 14.6 | 10.4 | 162.75 | 305.8 | 1.17 | 1.5 | 14 | 0.02 | 85.45 | 43.75527195 | 0.56 | 20 | 8.545 | 8.545 | 1.39
5 | 2.94 | 17 | 16.1 | 14.6 | 10.4 | 162.75 | 305.8 | 1.17 | 1.5 | 14 | 0.02 | 58.45 | 29.92973254 | 0.56 | 20 | 5.845 | 5.845 | 1.39
6 | 2.94 | 17 | 16.1 | 14.6 | 10.4 | 162.75 | 305.8 | 1.17 | 1.5 | 14 | 0.02 | 29.5 | 15.10568195 | 0.56 | 20 | 2.95 | 2.95 | 1.39

Sheet: Fatigue
C-1 The example ship’s main dimensions |  |  |  |  | Local Stress |  |  | S-N parameters for N </= 10^7 cycles |  |  | S-N parameters for N >/= 10^7 cycles |  |  | Stress range
Length of ship | L | 231 | m |  | K | 1.2995 | - | log (a) | a barra 1 | m1 | log (a) | a barra 2 | m2 | S1 [Mpa]
Breadth of ship | B | 34.60 | m |  | Me | 39262219.96 | N*mm | 12.164 | 1.45881426e+12 | 3 | 15.606 | 4.03645393e+15 | 5 | 50
Block coefficient | Cb | 0.78 | - |  | pe | 45.50 | kN/m^2
Design speed | Vs | 18.20 | knots |  | rp | 1 | -
Depth of ship | D | 18.10 | m |  | Sigma 2A | 12.85 | N/mm^2
Moment of inertia of hull cross-section about transverse neutral axis | I N | 226.1795291 | m^4 |  | Delta Sigma 1 | 25.7 | N/mm^2
Neutral axis above keel | Z NA | 7.56 | m
 |  |  |  |  | Global hull stresses
C-2 Definition of load conditions |  |  |  |  | Δσv | 114.9 | N/mm^2
 | Fully loaded |  |  |  | Δσhg | 0 | N/mm^2
Stillwater bending moment Hogging | 2081866.571 | kN*m |  |  | ρvh | 0.1 | -
Stillwater bending moment Sagging | -1807541.192 | kN*m |  |  | Δσg | 114.9 | N/mm^2
Draught | 13.2 | m
Metacentric height | 4.152 | m |  |  | Combined hot spot stresses
Roll radius of gyration | 8.65 | m |  |  | a | 0.6 | -
Part of time in load condition | 0.65 | - |  |  | b | 0.6 | -
Part of time in ballast condition | 0.2 | - |  |  | Δσ | 130.3 | N/mm^2
C-4 Scantlings and properties of stiffener considered |  |  |  |  | Auxiliary Table
Total Stiffener sectional modulus at top of flange | Zs | 5160000 | mm^3 |  | alfa 1 | 4.213197138
Quantity in plate | nº | 4 | stiffener |  | x1 | 3.766600576
Stiffener sectional modulus at top of flange | Z | 1290000 | mm^3 |  | Γ(α1,x1) | 4.138467984
Distance above keel | z | 17.84 | m |  | alfa 2 | 6.355328563
Effective span length | l | 3460 | mm |  | x2 | 3.766600576
Distance from end of stiffener to hot spot | x | 0 | mm |  | γ(α1,x1) | 31.394405
Web frame spacing | ls | 3460 | mm |  | (q^m1)/a barra 1 | 1.208566378e-09 |  | Fatigue part damage
Stiffener spacing | s | 865 | mm |  | (q^m2)/a barra 2 | 6.374569303e-11 |  | T d | 25 | years
Thickness of plate (plate 18) | tp | 25 | mm |  |  |  |  | v0 Td | 83389321.8 | cycles
Height of stiffener | h | 370 | mm |  |  |  |  | n0 | 10000 | -
Thickness of web | tw | 15 | mm |  |  |  |  | q | 12.08064631 | N/mm^2
 |  |  |  |  |  |  |  | D non corrosive | 0.584 | -
C.6.8 Long term distribution |  |  |  |  |  |  |  | D corrosive | 1.168 | -
ha | 0.05 |  |  |  |  |  |  | T c | 15 | years
h0 | 0.934
h | 0.934
 |  |  |  |  |  |  |  | D full load | D total | T Fatigue | D acceptable
K-Factor |  |  |  |  |  |  |  | 0.734 | 0.734 | 34.2 | 1
Misalignment | Misalignment inherent | Plate thickness | Factor
e | e_0 | t | Kte | Kg | Kaxial
[mm] | [mm] | [mm] | [-] | [-] | [-]
3.75 | 2.5 | 25 | 1.15 | 1.13 | 1.4
