davidemelozzi/Design-of-Ship-Structures/(list of files, cad)

Other CAD files:
Drawing_DEN_DavideMelozzi (2).dwg
